SmashedTransistors/Thierry-Rochebois-I/photos/SH1106_Params.jpg

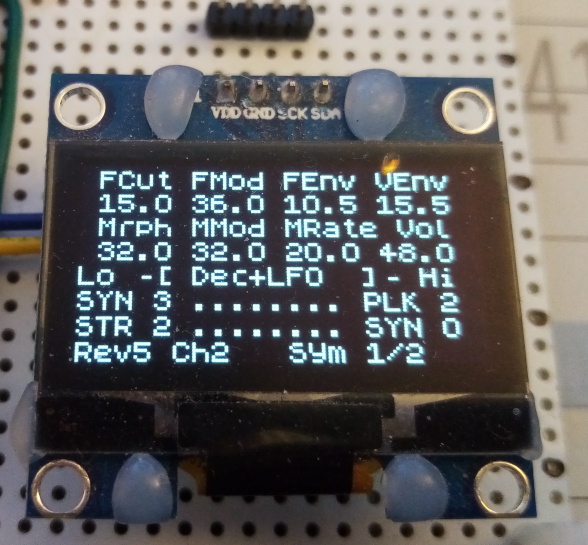
photos/SH1106_Params.jpg
