SmashedTransistors/Thierry-Rochebois-I/pictures/synthEngine.png

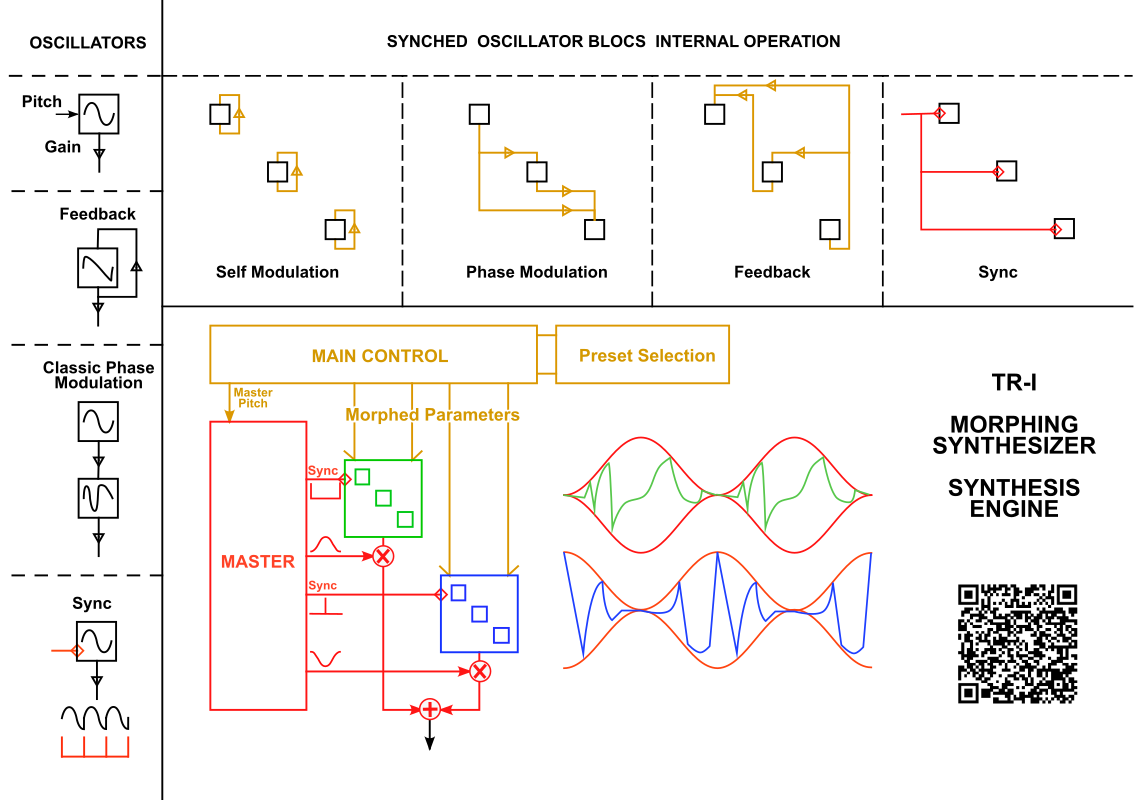
pictures/synthEngine.png
