SmashedTransistors/Thierry-Rochebois-I/HEX_Files/HowToUseAnHex.md

# HEX files for the teensy

Here is how to use the HEX files to program your Teensy4.1

[How to use the teensy Loader](https://www.pjrc.com/teensy/loader_win10.html)
