SmashedTransistors/Thierry-Rochebois-I/(commit log)

2025-01-17 Add files via upload
    This is the very first version of my very first teensy based synthesizer.
    7 Programs are available at the moment though MIDI Program Change.
    This synthesizer is based on TransDimensional Morphing that is a variant of TransWaves.
2025-01-18 Add files via upload
    The minimal set up to try this synthesizer : A Teensy4.1 and an I2S DAC breakout (here a UDA1334A breakout).
    Notice the 100ohm resistor I added at the WSel input to avoid inductive issues that happens with this breakout.
2025-01-18 Create HowToUseAnHex.md
    Link to PJRC Teensy downloader page
2025-01-18 PCM5102A with SCK solder blob
2025-01-26 Compatibility with Teensy Audio Adaptor
    I2C control added : enable + setVolume to 1 when using Teensy Audio Adaptor
2025-08-02 Save current to preset
    CC119 save current state to preset in EEPROM
2025-08-03 Save current preset to EEPROM
    + preparing for get settings from the teensy
2025-08-03 Get and Save editor <-> teensy
